playduino/sheep-tester/needle adapter/needle adapter connector pin1.png

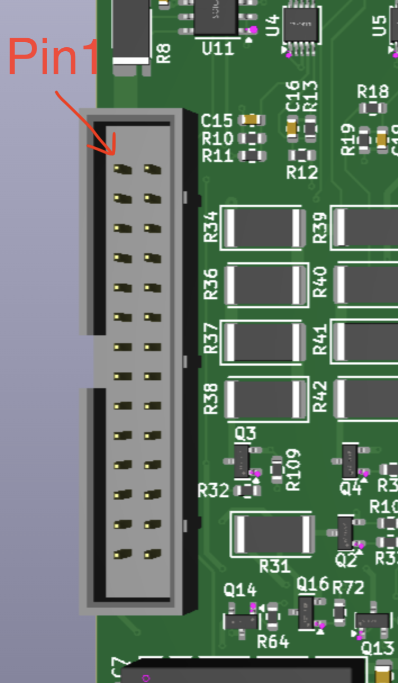
needle adapter/needle adapter connector pin1.png
