playduino/sheep-tester/needle adapter/needle adapter connector.png

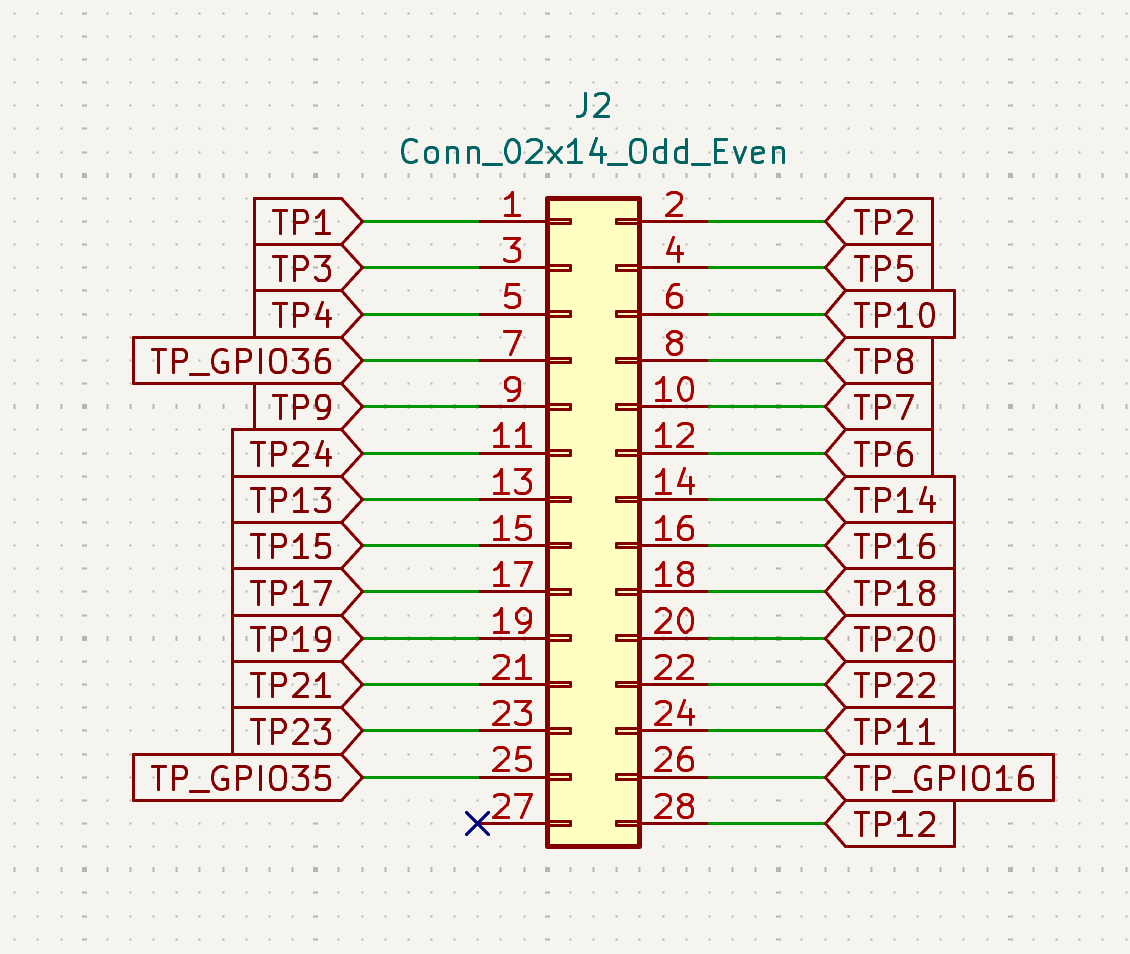
needle adapter/needle adapter connector.png
