playduino/sheep-tester/SHEEP TEST PINS.xlsx

Testpoint | Signal | Tests | Hardware requirement | Signals | RPI pin | DO | DI | AI | CM
TP1 | GND | GND | current measurement |  |  |  |  |  | I2C
TP2 | GND | detect if adapter is closed | digital input with pullup |  |  |  | #GPIO12
TP3 | 3.3VLAN | should be 3.3V if GPIO12 = HIGH | analog measurement ~ 3.3V |  |  |  |  | AIN0_U4
TP4 | 12V | should be 12V even under load | analog measurement ~ 12V, switchable load |  |  | B0_U2 |  | AIN1_U4
TP5 | 3.3V | should be 3.3V even under load | analog measurement ~ 3.3V, switchable load |  |  | B1_U2 |  | AIN2_U4
TP6 | DCIN @ klemme | should be 0V when PoE, should be one way to power | analog measurement ~ 60V, switchable 60V supply, switchable 12V current protected supply |  |  | B5_U2_U12 = 60V / #12V preselect, B3_U2 = 60V, B4_U2 = 12V |  | AIN3_U4
TP7 | VIN @ buck eingang | should be 50V when PoE, 60V when DCIN | analog measurement ~ 60V, switchable 60V supply |  |  | B6_U3 |  | AIN0_U5
TP8 | PG / EN buck | should ~4,1V when PoE or DC_IN | analog measurement |  |  |  |  | AIN1_U5
TP9 | REV detection | should be 10k when sheep version 1.4 | voltage divider + analog measurements |  |  |  |  | AIN2_U5
TP10 | 5V | should be 5V even under load | analog measurement ~ 5V, switchable load |  |  | B2_U2 |  | AIN3_U5
TP11 | GPIO15 / I2C2 / SDA | I2C should work | ESP signal feedback through serial connection |  |  | B6_U2
TP12 | GPIO13 / I2C2 / SCL | I2C should work | ESP signal feedback through serial connection |  |  | A3_U2
TP13 | ESP_EN | programming pin | add relay between raspberry pins and DUT to protect Pi |  | GPIO6 (relay protected) | relays = A7_U2_U12
TP14 | GPIO3 / RXD | programming pin | add relay between raspberry pins and DUT to protect Pi |  | GPIO14 (relay protected)
TP15 | GPIO1 / TXD | programming pin | add relay between raspberry pins and DUT to protect Pi |  | GPIO15 (relay protected)
TP16 | GPIO0 / BOOT | programming pin | add relay between raspberry pins and DUT to protect Pi |  | GPIO5 (relay protected)
TP17 | GPI39 / NTC AIN | ntc emulation (only if no NTC present, but it will be present) | switchable analog voltage for NTC emulation |  |  | B0_U3_U12
TP18 | SMOKE signal | smoke alarm simulation | switchable 12V (take the voltage from sheep itself) |  |  | A6_U2_U12
TP19 | GPI34 / SMOKE signal divided | smoke signal voltage divider test | analog measurement ~ 3.3V |  |  |  |  | AIN0_U6
TP20 | GPIO5 / I2C / SDA | I2C should work | OC output to test the pullups, ESP signal feedback through serial connection |  |  | A2_U2 | A0_U2 | AIN3_U6
TP21 | GPIO33 / I2C / SCL | I2C should work | OC output to test the pullups, ESP signal feedback through serial connection |  |  | B7_U2 | A1_U2 | AIN0_U7
TP22 | beeper, cathode | beeper test | connect to GND, measure current, measure voltage ~5V when ESP tests it |  |  | A4_U2 |  | AIN1_U6
TP23 | IR diodes, cathode | IR diode test, IR receiver test | connect to GND, measure current, measure voltage ~5V when ESP tests it |  |  | A5_U2 |  | AIN2_U6
TP24 | WS2812B, dataout | test LED data connection | check if LED signal comes out |  |  | relay = B4_U3_U12 | GPIO13
TP_GPIO35 | GPIO35 | Papir connection | OC output at pi pullup at pi, ESP signal feedback through serial connection |  |  |  | B1_U3
TP_GPIO16 | GPIO16 / U1TXD | mmWave signals | OC output at pi pullup at pi, ESP signal feedback through serial connection |  |  |  | B2_U3
TP_GPIO36 | GPI36 / U1RXD | mmWave signals | OC output at pi pullup at pi, ESP signal feedback through serial connection |  |  |  | B3_U3
 | PoE | PoE injection test | TP-Link TL-SG1005LP, switchable LAN connection |  |  | B5_U3_U12
 | QR code | read the QR code | usb qr code scanner
 | shutdown button |  |  |  |  |  | GPIO26
 | LED GOOD |  |  |  |  | GPIO20
 | LED BAD |  |  |  |  | GPIO21
 | 7SEG_A_0 |  |  |  |  | GPIO17
 | 7SEG_B_0 |  |  |  |  | GPIO18
 | 7SEG_C_0 |  |  |  |  | GPIO27
 | 7SEG_D_0 |  |  |  |  | GPIO22
 | 7SEG_E_0 |  |  |  |  | GPIO23
 | 7SEG_F_0 |  |  |  |  | GPIO24
 | 7SEG_G_0 |  |  |  |  | GPIO10
 | 7SEG_A_1 |  |  |  |  | GPIO25
 | 7SEG_B_1 |  |  |  |  | GPIO9
 | 7SEG_C_1 |  |  |  |  | GPIO8
 | 7SEG_D_1 |  |  |  |  | GPIO11
 | 7SEG_E_1 |  |  |  |  | GPIO7
 | 7SEG_F_1 |  |  |  |  | GPIO19
 | 7SEG_G_1 |  |  |  |  | GPIO16
 | MCP23017_#RESET |  |  |  |  | GPIO4
 | SDA |  |  |  |  | GPIO2
 | SCL |  |  |  |  | GPIO3
