playduino/sheep-tester/playduino_sheep_tester/parts/TS-1088-AR02016/TS-1088-AR02016.step

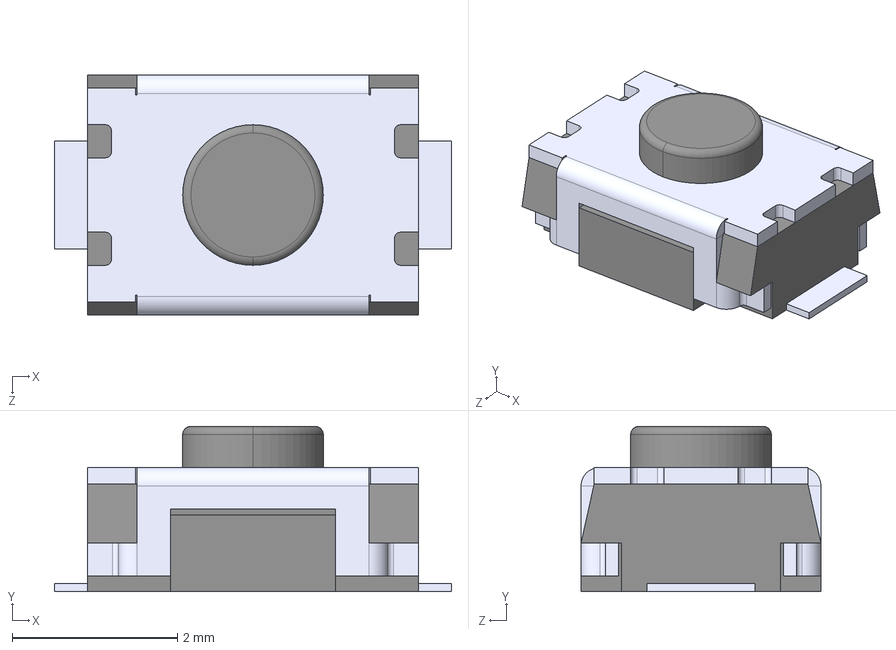
[picture p3: CAD file, 2025-11-21]
playduino_sheep_tester/parts/TS-1088-AR02016/TS-1088-AR02016.step
4.80 x 2.00 x 2.90 mm
