playduino/sheep-tester/playduino_sheep_tester/parts/ul_B0505S-2WR3/B_S-2WR2_MNS.step

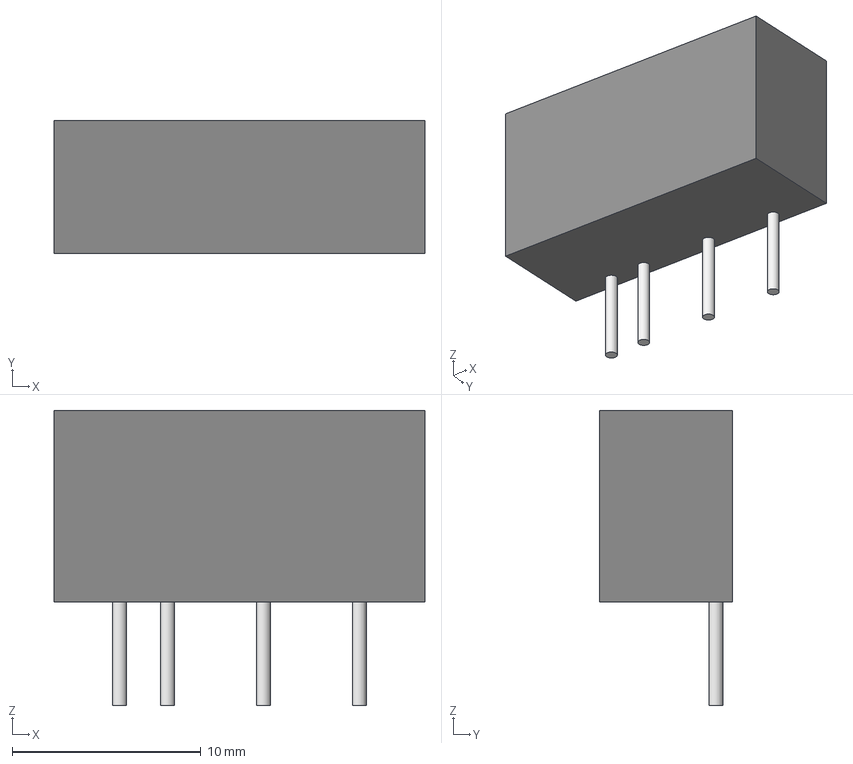
[picture p4: CAD file, 2025-11-21]
playduino_sheep_tester/parts/ul_B0505S-2WR3/B_S-2WR2_MNS.step
19.7 x 7.06 x 15.6 mm
