playduino/sheep-tester/playduino_sheep_tester/parts/WS2812B2020/ws2812-2020-1/WS2812-2020.STEP

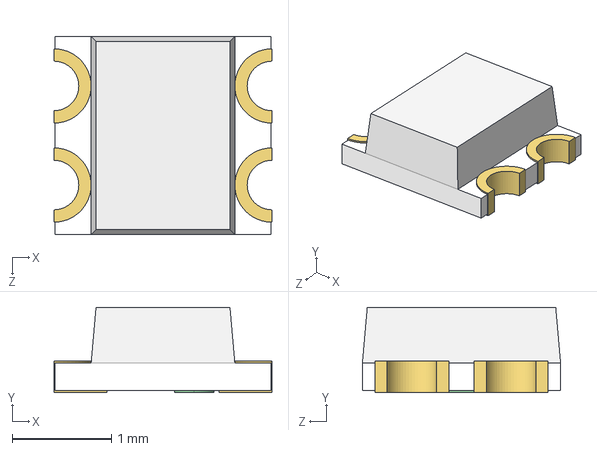
[picture p5: CAD file, 2025-11-21]
playduino_sheep_tester/parts/WS2812B2020/ws2812-2020-1/WS2812-2020.STEP
2.20 x 0.86 x 2.00 mm
