playduino/sheep-tester/playduino_sheep_tester/parts/WS2812B2020/WS2812B2020.step

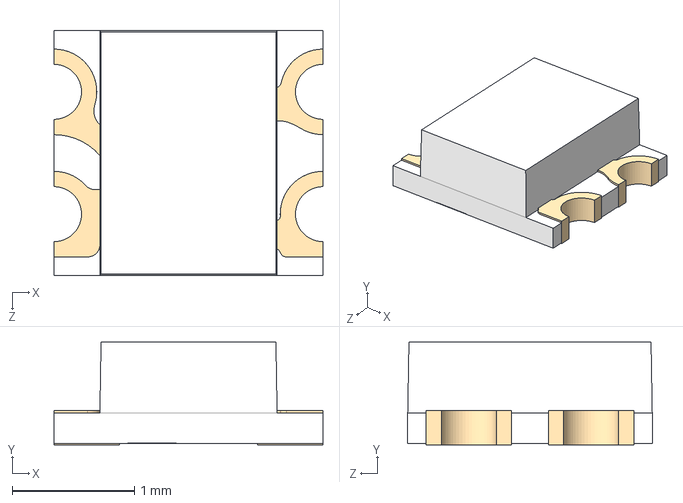
[picture p6: CAD file, 2025-11-21]
playduino_sheep_tester/parts/WS2812B2020/WS2812B2020.step
2.20 x 0.84 x 2.00 mm
