playduino/sheep-tester/playduino_sheep_tester/parts/5520259-4/5520259-4.stp

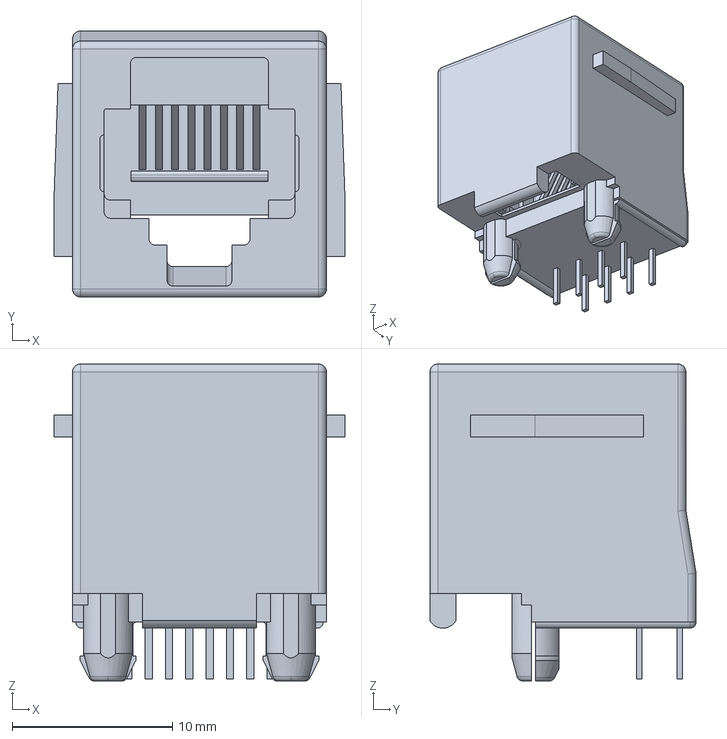
[picture p7: CAD file, 2025-11-21]
playduino_sheep_tester/parts/5520259-4/5520259-4.stp
18.2 x 16.6 x 19.8 mm
