playduino/sheep-tester/(list of files, cad)

Other CAD files:
playduino_sheep_tester/parts/WS2812B2020/ws2812-2020-1/WS2812-2020.SLDPRT
