playduino/sheep-tester/needle adapter/testplatinen.pdf

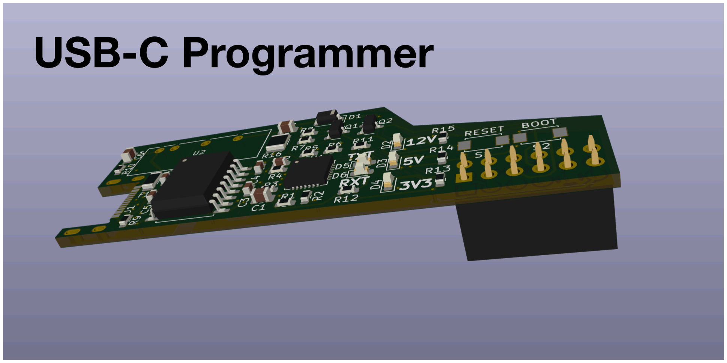
[picture p8: page 1]

USB-C Programmer

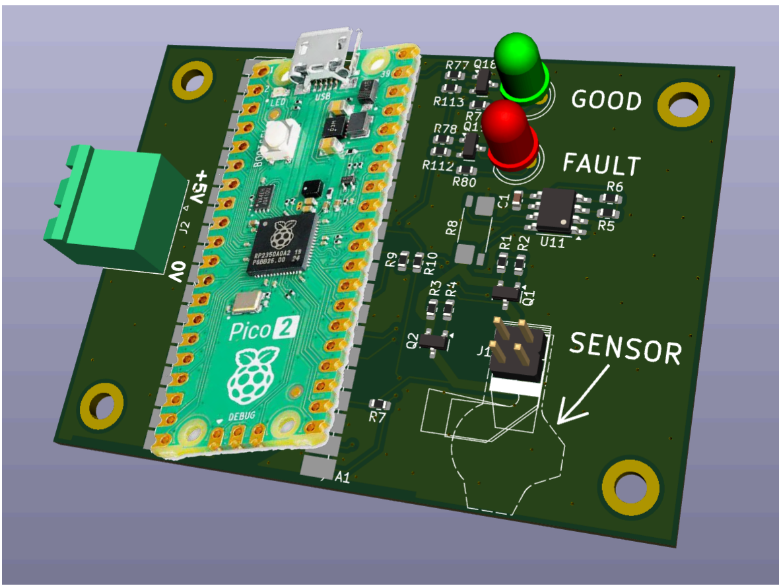
[picture p9: figure]

Sensor Module Tester

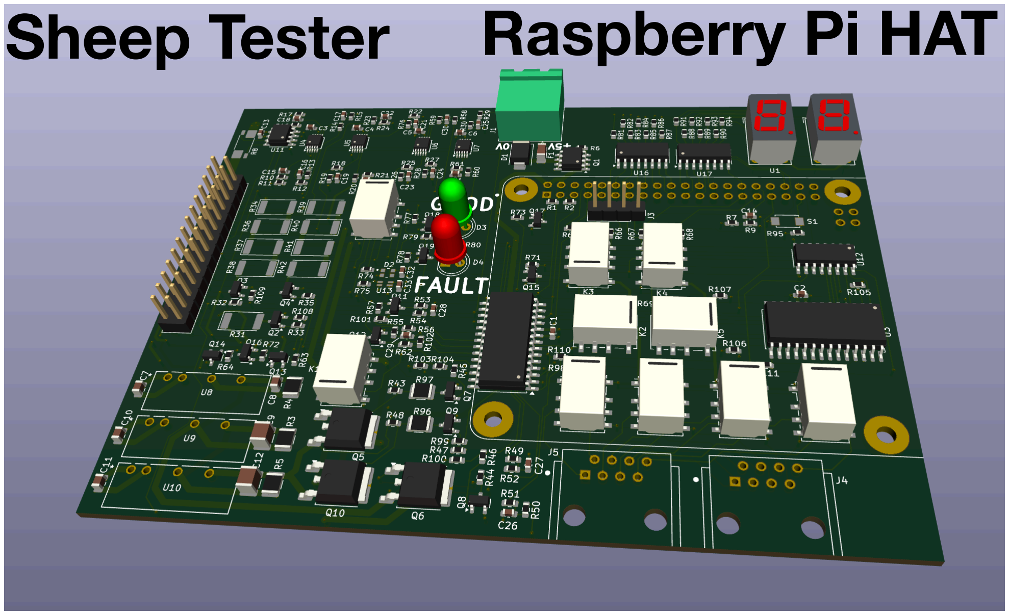
[picture p10: page 3]

Sheep Tester Raspberry Pi HAT

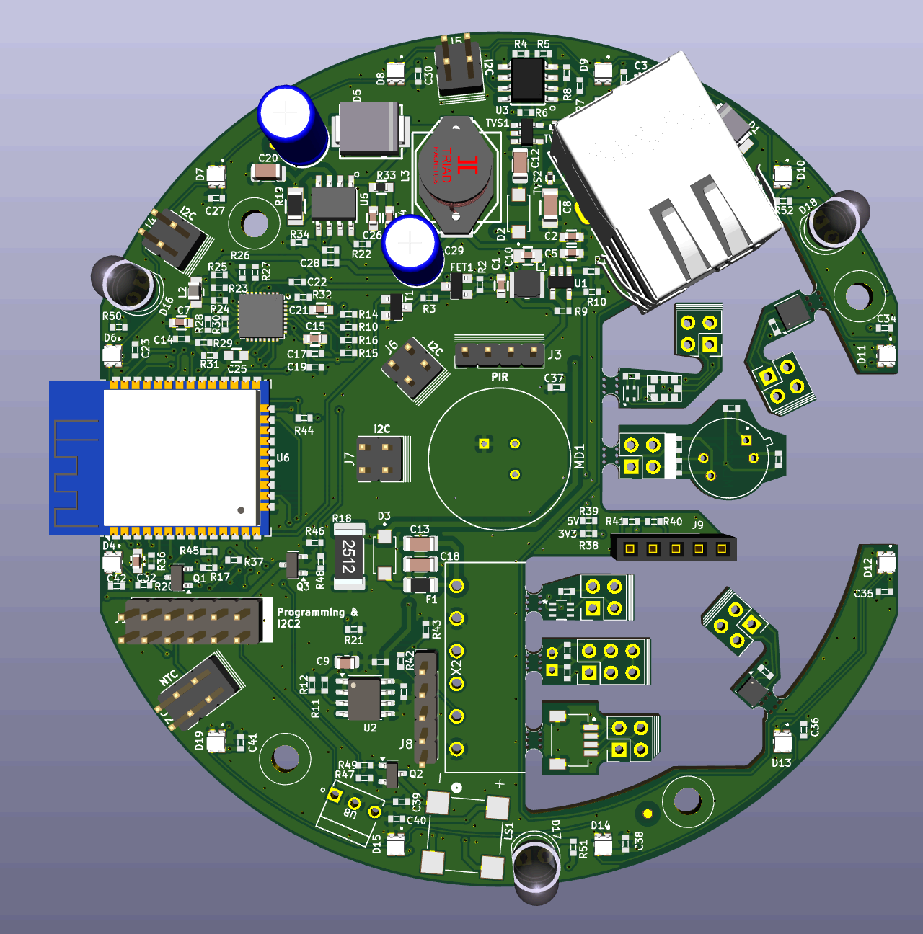
[picture p11: figure]

Nadeladapter

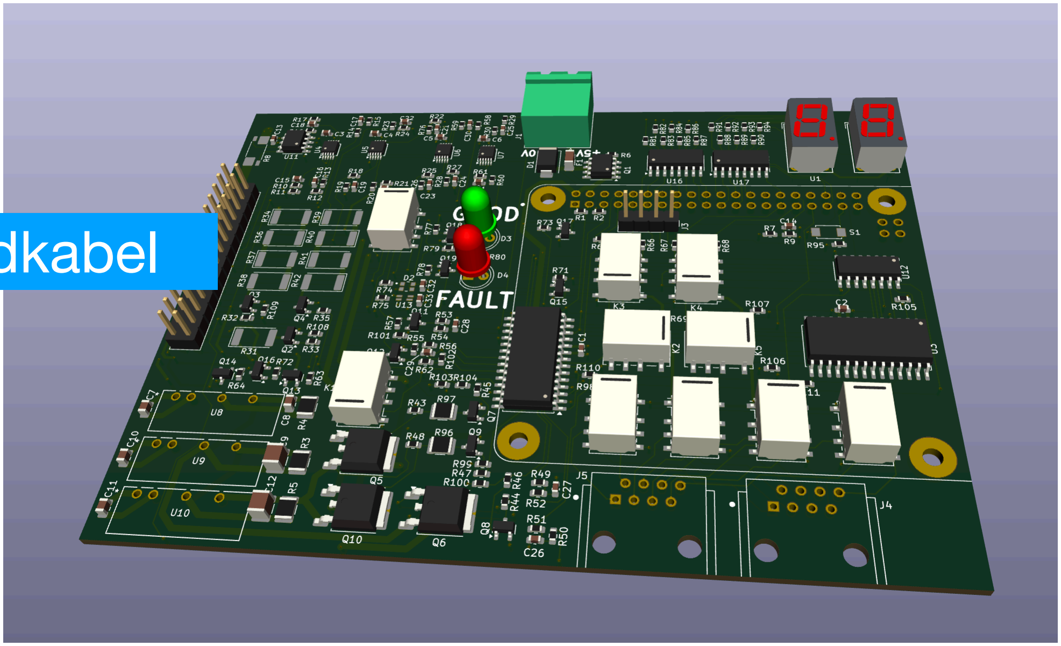
[picture p12: figure]

Flachbandkabel

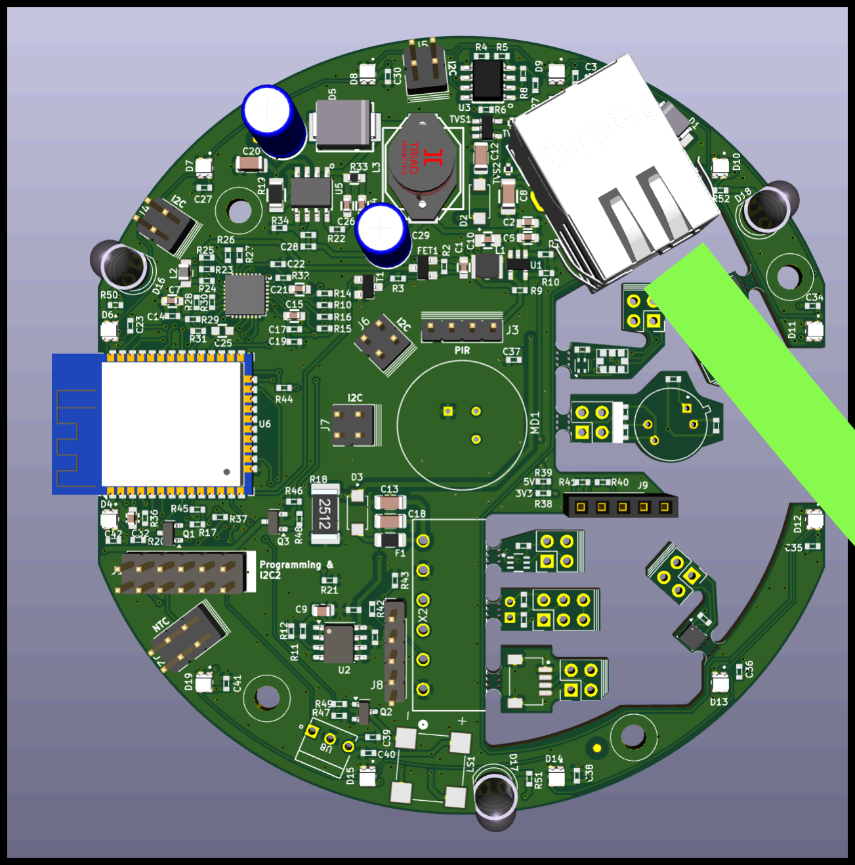
[picture p13: figure]

Nadeladapter

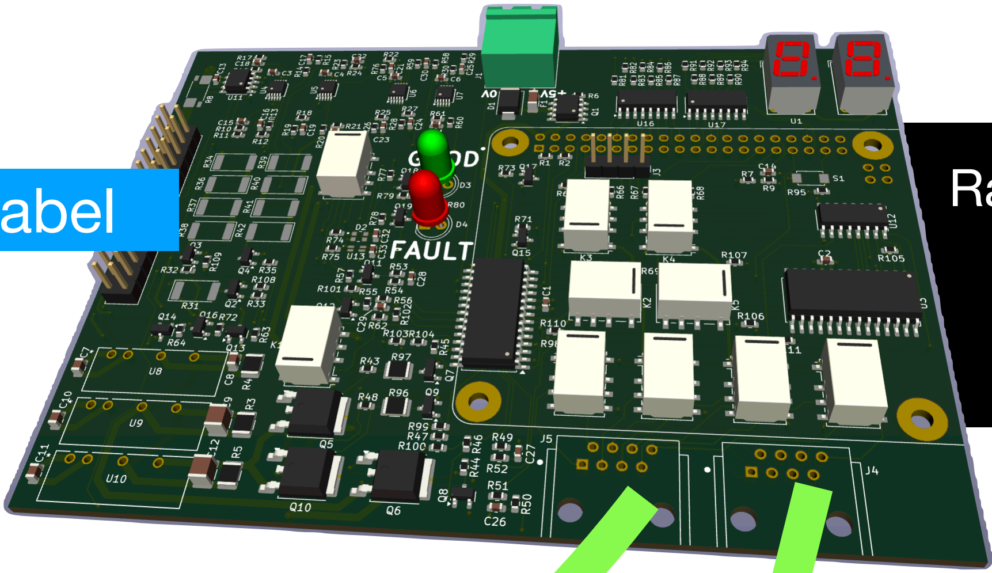
[picture p14: figure]

Flachbandkabel

PoE Switch

Raspberry

Pi

Ethernet
Ethernet | Ethernet
