playduino/sheep-tester/needle adapter/Sheep Needles.pdf

## PAO

TP | D8

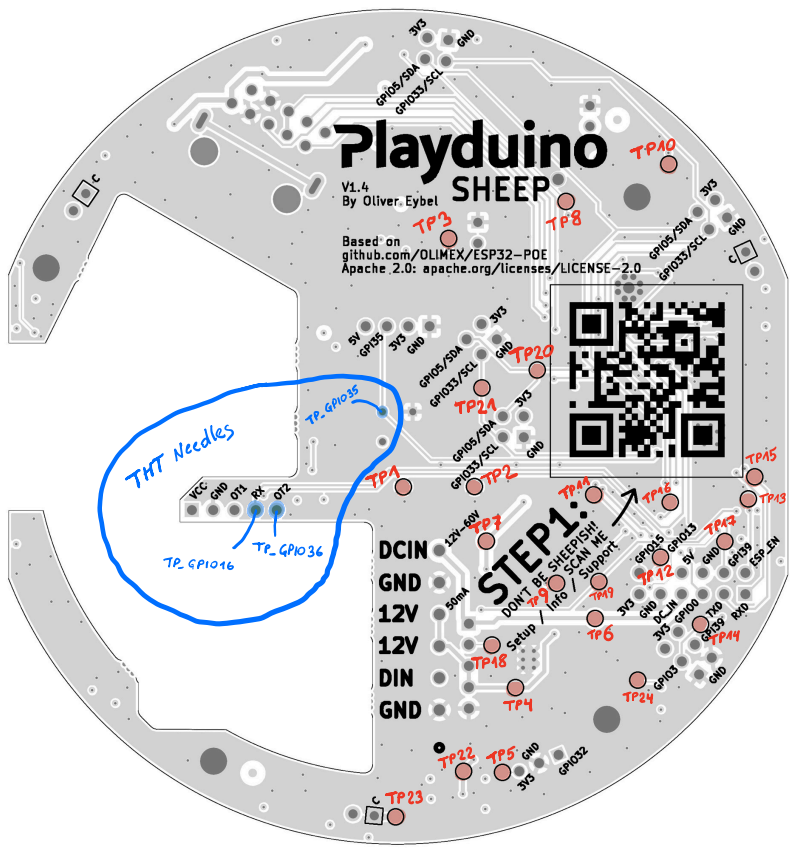
[picture p15: page 1]
gar; Need; ppm; TPA5; gprb; TP17-TP.GR GPIO36-TP9 p1gTETE-TP6; TPH
