playduino/sheep-tester/(commit log)

2025-11-21 fix hex address of ADC
    [analog inputs.kicad_sch]
2025-11-22 add mounting holes
    [CPL-playduino_sheep_tester.csv, playduino_sheep_tester-CuBottom.gbr, playduino_sheep_tester-CuIn1.gbr, playduino_sheep_tester-CuIn2.gbr, playduino_sheep_tester-CuTop.gbr, playduino_sheep_tester-EdgeCuts.gbr, playduino_sheep_tester-MaskBottom.gbr, playduino_sheep_tester-MaskTop.gbr]
2025-11-22 small improvements and fixing horrible mistakes
    change A3_U2 and B7_U2 because of known issues with MCP23017
    https://support.microchip.com/s/article/GPA7---GPB7-Cannot-Be-Used-as-Inputs-In-MCP23017
    add resistor to MCP23017 address pins
    replace B3_U2 duplicate with B6_U3
    [BOM-playduino_sheep_tester.csv, current_measurement_and_loads.kicad_sch, digital_io_expanders.kicad_sch, dut.kicad_sch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]
2025-11-22 fix SDA and SCL @ INA219 (U11)
    [current_measurement_and_loads.kicad_sch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]
2025-11-22 small improvements, add GPIOs to excel
    [SHEEP TEST PINS.xlsx, analog inputs.kicad_sch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]
2025-11-23 small silkscreen improvements
    [CPL-playduino_sheep_tester.csv, playduino_sheep_tester-CuBottom.gbr, playduino_sheep_tester-CuIn1.gbr, playduino_sheep_tester-CuIn2.gbr, playduino_sheep_tester-CuTop.gbr, playduino_sheep_tester-EdgeCuts.gbr, playduino_sheep_tester-MaskBottom.gbr, playduino_sheep_tester-MaskTop.gbr]
2025-11-23 avoid collision with connector and move raspberry pi connector to the bottom
    [CPL-playduino_sheep_tester.csv, playduino_sheep_tester-CuBottom.gbr, playduino_sheep_tester-CuIn1.gbr, playduino_sheep_tester-CuIn2.gbr, playduino_sheep_tester-CuTop.gbr, playduino_sheep_tester-EdgeCuts.gbr, playduino_sheep_tester-MaskBottom.gbr, playduino_sheep_tester-MaskTop.gbr]
2025-11-24 use BASIC components
    [playduino_sheep_tester.kicad_pcb]
2025-11-24 use more basic parts
    [BOM-playduino_sheep_tester.csv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]
2025-11-25 corrected wrong BASIC component
    [BOM-playduino_sheep_tester.csv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]
2025-12-01 correct GPIOs in excel
    [SHEEP TEST PINS.xlsx]
2025-12-01 correct GPIO35 for PaPir Testpoint
    [dut.kicad_sch, playduino_sheep_tester.kicad_pcb]
